Berkays/ReflowPlate/3D/README.md

## About

This project contains 3D models and design files used to create an enclosing box for the reflow plate system. It supports 4010 capacitor cooling fan, 128x64 0.96" OLED display, Rotary encoder module.

Public Onshape project can be accessed at [https://cad.onshape.com/documents/fabf8b8485aba982e8e00938/w/3c16bb25b752a8fd39e094e7/e/187e14039f52f81eb8a33bf7](https://cad.onshape.com/documents/fabf8b8485aba982e8e00938/w/3c16bb25b752a8fd39e094e7/e/187e14039f52f81eb8a33bf7)

## License

<br />This work is licensed under a <a rel="license" href="http://creativecommons.org/licenses/by/3.0/">Creative Commons Attribution 3.0 Unported License</a>.
