Berkays/ReflowPlate/GUI/README.md

## About

This project contains PC application for monitoring and profile load/save purposes. Application is developed with Electron to be cross compatible with all major platforms. App is developed with Jlink RTT communication. Standard STLink can be converted to a JLink Device with the official [SEGGER STLinkReflash utility](https://www.segger.com/products/debug-probes/j-link/models/other-j-links/st-link-on-board/) tool.

## Attribution

Dependecies below are used to realize this project. Be aware that these dependecies may have different licenses and may not be suitable for your use case.

- [ElectronJS](https://github.com/electron/electron)

## License

This project is licensed under the MIT License - see the [LICENSE](LICENSE) file for details.
