Berkays/ReflowPlate/Firmware/src/modules/Display/u8g2_font_unifont_t_symbols.png

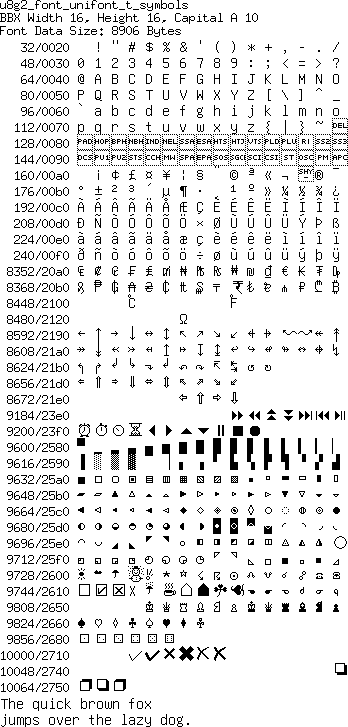
Firmware/src/modules/Display/u8g2_font_unifont_t_symbols.png
