Berkays/ReflowPlate/Hardware/V1.0_BOM.csv

ID | Name | Designator | Footprint | Quantity | Manufacturer Part | Manufacturer | Supplier | Supplier Part | Price
1 | 4.7uF | C11,C6,C8 | C0805 | 3 | CL21A475KAQNNNE | SAMSUNG(三星) | LCSC | C1779 | 0.011
2 | 2kΩ | R7 | R0805 | 1 | 0805W8F2001T5E | UNI-ROYAL(厚声) | LCSC | C17604 | 0.002
3 | 100nF | C16,C3,C4,C5,C7 | C0805 | 5 | CC0805KRX7R9BB104 | YAGEO(国巨) | LCSC | C49678 | 0.005
4 | NTC2 | H6 | HDR-F-2.54_1X2 | 1 |  |  | LCSC | C49661 | 0.035
5 | 10kΩ | R6,R14,R1,R4,R8 | R0805 | 5 | 0805W8F1002T5E | UNI-ROYAL(厚声) | LCSC | C17414 | 0.001
6 | 7A | 7A | FUSE-SMD_L6.1-W2.6 | 1 | S6125-F-5.0A | SART(萨特) | LCSC | C553942 | 0.115
7 | FAN | H5 | HDR-F-2.54_1X2 | 1 |  |  | LCSC | C49661 | 0.035
8 | AO3400A | Q4 | SOT-23-3_L2.9-W1.6-P1.90-LS2.8-BR | 1 | AO3400A | AOS | LCSC | C20917 | 0.074
9 | 150Ω | R13,R12 | R0805 | 2 | 0805W8F1500T5E | UNI-ROYAL(厚声) | LCSC | C17471 | 0.002
10 | 22uF | C1 | C0805 | 1 | CL21A226MAQNNNE | SAMSUNG(三星) | LCSC | C45783 | 0.026
11 | 10uF | C2 | C0805 | 1 | CL21A106KAYNNNE | SAMSUNG(三星) | LCSC | C15850 | 0.013
12 | 10nF | C9 | C0805 | 1 | CL21B103KBANNNC | SAMSUNG(三星) | LCSC | C1710 | 0.009
13 | 1u | C10 | CAP-D3.0×F1.5 | 1
14 | B5819W | D1,D2,D3 | SOD-123_L2.7-W1.6-LS3.7-RD-1 | 3 | B5819W SL | CJ(江苏长电/长晶) | LCSC | C8598 | 0.03
15 | SS8050 | Q1 | SOT-23-3_L2.9-W1.3-P1.90-LS2.4-BR | 1 | SS8050 | CJ(江苏长电/长晶) | LCSC | C2150 | 0.015
16 | IRLR8726TRPBF | Q2 | TO-252-2_L6.6-W6.1-P4.58-LS9.9-TL | 1 | IRLR8726TRPBF | Infineon(英飞凌) | LCSC | C81137 | 0.18
17 | WSP4409A | Q3 | SOP-8_L4.9-W3.9-P1.27-LS6.0-BL | 1 | WSP4409A | WINSOK微硕 | LCSC | C2880527 | 0.458
18 | 1kΩ | R2 | R0805 | 1 | 0805W8F1001T5E | UNI-ROYAL(厚声) | LCSC | C17513 | 0.002
19 | 4.7kΩ | R3 | R0805 | 1 | 0805W8F4701T5E | UNI-ROYAL(厚声) | LCSC | C17673 | 0.002
20 | 100kΩ | R5,R11 | R0805 | 2 | 0805W8F1003T5E | UNI-ROYAL(厚声) | LCSC | C149504 | 0.002
21 | 390kΩ | R10 | R0805 | 1 | 0805W8F3903T5E | UNI-ROYAL(厚声) | LCSC | C17656 | 0.002
22 | AMS1117-3.3 | U4 | SOT-223-3_L6.5-W3.4-P2.30-LS7.0-BR | 1 | AMS1117-3.3 | AMS | LCSC | C6186 | 0.144
23 | STM32F030C8T6 | U1 | LQFP-48_L7.0-W7.0-P0.50-LS9.0-BL | 1 | STM32F030C8T6 | ST | LCSC | C23922 | 0.912
24 | Encoder | H1 | HDR-F-2.54_1X5 | 1 |  |  | LCSC | C50950 | 0.06
25 | DISPLAY | H2 | HDR-F-2.54_1X4 | 1 |  |  | LCSC | C225501 | 0.076
26 | NTC | H3 | HDR-F-2.54_1X2 | 1 |  |  | LCSC | C49661 | 0.035
27 | SWD | H4 | HDR-F-2.54_1X4 | 1 |  |  | LCSC | C225501 | 0.076
28 | 680uF | C12,C13,C14,C15 | CAP-D10.0×F5.0 | 4
29 | 5.0-02P | U2 | CONN-TH_DG125-5.0-02P-14-00A | 1 | DG125-5.0-02P-14-00A(H) | DEGSON(高正) | LCSC | C784572 | 0.32
30 | PWR | LED1 | LED-TH_BD3.0_RED | 1 | 204-10SDRD/S530-A3-L | EVERLIGHT(台湾亿光) | LCSC | C84774 | 0.035
31 | 5.0-2P | U5 | CONN-TH_DG125-5.0-02P-14-00A | 1 | DG125-5.0-02P-14-00A(H) | DEGSON(高正) | LCSC | C784572 | 0.32
32 | SHORTING_LINK | LK3 | SHORTING_LINK_DIFF_NAMED_NETS | 1
