Berkays/ReflowPlate/Hardware/V1.0_Schematic.pdf

+

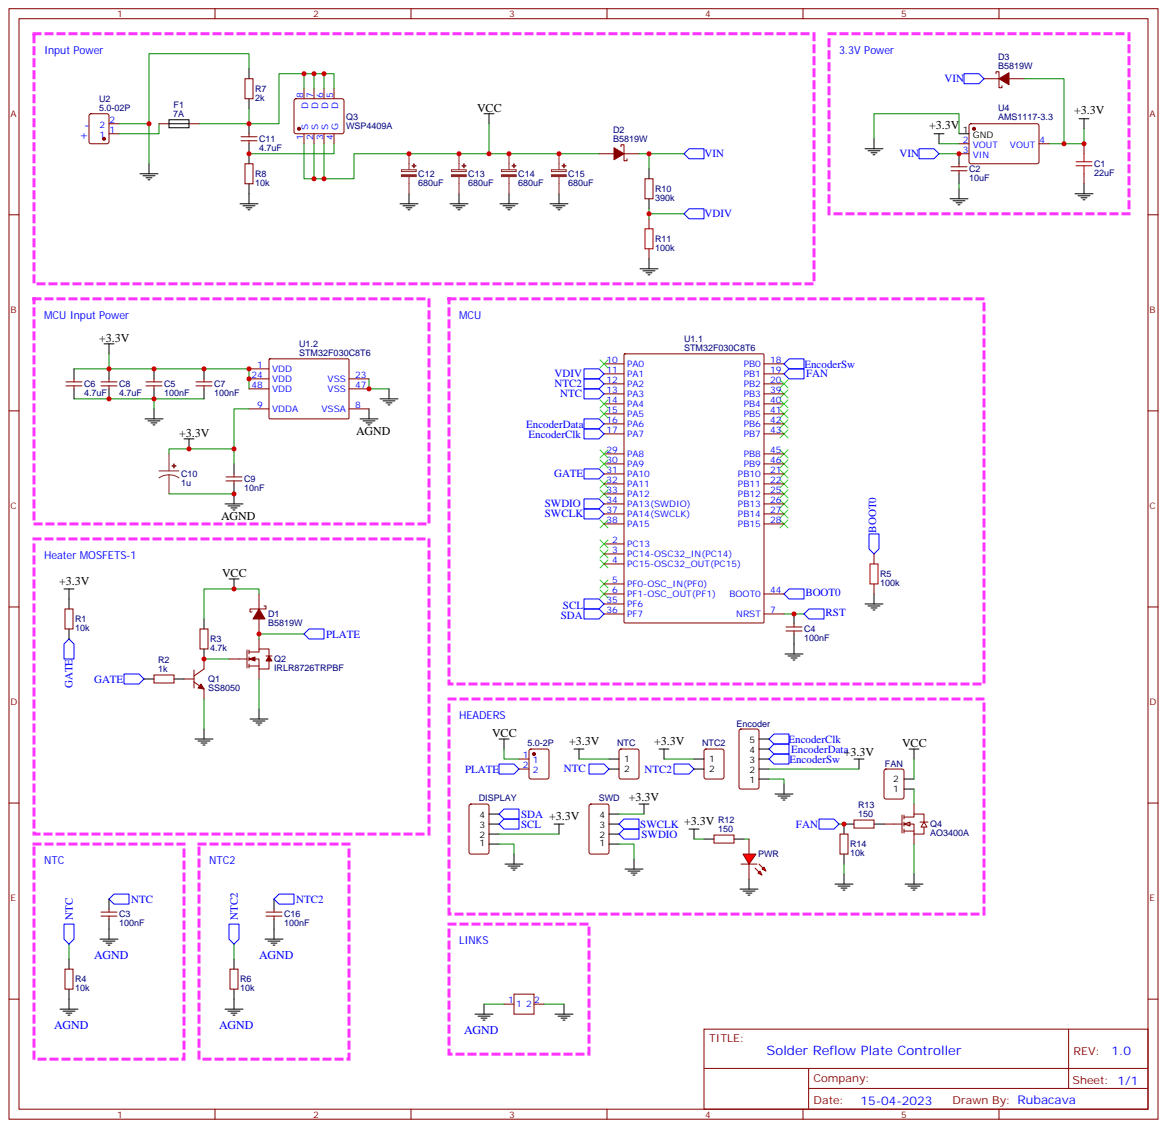
[picture p3: page 1]
