Berkays/ReflowPlate/CubeMx/V1.1_ReflowPlate.ioc

Mcu.UserName=STM32F030C8Tx
PA1.GPIO_Label=VDIV
PA1.Signal=ADC_IN1
PA10.GPIO_Label=GATE
PA10.Signal=S_TIM1_CH3
PA13.Signal=SYS_SWDIO
PA14.Signal=SYS_SWCLK
PA2.GPIO_Label=NTC2
PA2.Signal=ADC_IN2
PA3.GPIO_Label=NTC
PA3.Signal=ADC_IN3
PA6.GPIO_Label=EncoderData
PA6.Signal=S_TIM3_CH1
PA7.GPIO_Label=EncoderCLK
PA7.Signal=S_TIM3_CH2
PB0.GPIO_Label=SW
PB0.Signal=GPIO_Input
PB1.GPIO_Label=FAN
PB1.Signal=GPIO_Output
PB6.Signal=USART1_TX
PB7.Signal=USART1_RX
PC14-OSC32_IN.GPIO_Label=STATUS_LED
PC14-OSC32_IN.Signal=GPIO_Output
PF6.GPIO_Label=SCL
PF6.Signal=I2C2_SCL
PF7.GPIO_Label=SDA
PF7.Signal=I2C2_SDA
