Berkays/ReflowPlate/Firmware/src/STM32F030C8/peripherals.cpp

#include "peripherals.h"

ADC_HandleTypeDef hadc = {};
I2C_HandleTypeDef hi2c2 = {};
TIM_HandleTypeDef htim1 = {};
TIM_HandleTypeDef htim3 = {};
TIM_HandleTypeDef htim6 = {};
TIM_HandleTypeDef htim15 = {};
UART_HandleTypeDef huart1 = {};

void InitPeripherals(void)
{
    HAL_Init();

    SystemClock_Config();
    MX_GPIO_Init();
    MX_ADC_Init();
    MX_I2C2_Init();
    MX_TIM1_Init();
    MX_TIM3_Init();
    MX_TIM6_Init();
    MX_TIM15_Init();
    MX_USART1_UART_Init();
}

void SystemClock_Config(void)
{
    RCC_OscInitTypeDef RCC_OscInitStruct = {0};
    RCC_ClkInitTypeDef RCC_ClkInitStruct = {0};
    RCC_PeriphCLKInitTypeDef PeriphClkInit = {0};

    /** Initializes the RCC Oscillators according to the specified parameters
     * in the RCC_OscInitTypeDef structure.
     */
    RCC_OscInitStruct.OscillatorType = RCC_OSCILLATORTYPE_HSI | RCC_OSCILLATORTYPE_HSI14;
    RCC_OscInitStruct.HSIState = RCC_HSI_ON;
    RCC_OscInitStruct.HSI14State = RCC_HSI14_ON;
    RCC_OscInitStruct.HSICalibrationValue = RCC_HSICALIBRATION_DEFAULT;
    RCC_OscInitStruct.HSI14CalibrationValue = 16;
    RCC_OscInitStruct.PLL.PLLState = RCC_PLL_ON;
    RCC_OscInitStruct.PLL.PLLSource = RCC_PLLSOURCE_HSI;
    RCC_OscInitStruct.PLL.PLLMUL = RCC_PLL_MUL12;
    RCC_OscInitStruct.PLL.PREDIV = RCC_PREDIV_DIV1;
    if (HAL_RCC_OscConfig(&RCC_OscInitStruct) != HAL_OK)
    {
        Error_Handler();
    }

    /** Initializes the CPU, AHB and APB buses clocks
     */
    RCC_ClkInitStruct.ClockType = RCC_CLOCKTYPE_HCLK | RCC_CLOCKTYPE_SYSCLK | RCC_CLOCKTYPE_PCLK1;
    RCC_ClkInitStruct.SYSCLKSource = RCC_SYSCLKSOURCE_PLLCLK;
    RCC_ClkInitStruct.AHBCLKDivider = RCC_SYSCLK_DIV1;
    RCC_ClkInitStruct.APB1CLKDivider = RCC_HCLK_DIV1;

    if (HAL_RCC_ClockConfig(&RCC_ClkInitStruct, FLASH_LATENCY_1) != HAL_OK)
    {
        Error_Handler();
    }
    PeriphClkInit.PeriphClockSelection = RCC_PERIPHCLK_USART1;
    PeriphClkInit.Usart1ClockSelection = RCC_USART1CLKSOURCE_PCLK1;
    if (HAL_RCCEx_PeriphCLKConfig(&PeriphClkInit) != HAL_OK)
    {
        Error_Handler();
    }
}

/**
 * @brief ADC Initialization Function
 * @param None
 * @retval None
 */
void MX_ADC_Init(void)
{

    ADC_ChannelConfTypeDef sConfig = {0};

    /** Configure the global features of the ADC (Clock, Resolution, Data Alignment and number of conversion)
     */
    hadc.Instance = ADC1;
    hadc.Init.ClockPrescaler = ADC_CLOCK_ASYNC_DIV1;
    hadc.Init.Resolution = ADC_RESOLUTION_12B;
    hadc.Init.DataAlign = ADC_DATAALIGN_RIGHT;
    hadc.Init.ScanConvMode = ADC_SCAN_DIRECTION_FORWARD;
    hadc.Init.EOCSelection = ADC_EOC_SEQ_CONV;
    hadc.Init.LowPowerAutoWait = DISABLE;
    hadc.Init.LowPowerAutoPowerOff = DISABLE;
    hadc.Init.ContinuousConvMode = DISABLE;
    hadc.Init.DiscontinuousConvMode = DISABLE;
    hadc.Init.ExternalTrigConv = ADC_SOFTWARE_START;
    hadc.Init.ExternalTrigConvEdge = ADC_EXTERNALTRIGCONVEDGE_NONE;
    hadc.Init.DMAContinuousRequests = DISABLE;
    hadc.Init.Overrun = ADC_OVR_DATA_OVERWRITTEN;
    if (HAL_ADC_Init(&hadc) != HAL_OK)
    {
        Error_Handler();
    }

    /** Configure for the selected ADC regular channel to be converted.
     */
    sConfig.Channel = ADC_CHANNEL_1;
    sConfig.Rank = ADC_RANK_CHANNEL_NUMBER;
    sConfig.SamplingTime = ADC_SAMPLETIME_13CYCLES_5;
    if (HAL_ADC_ConfigChannel(&hadc, &sConfig) != HAL_OK)
    {
        Error_Handler();
    }

    /** Configure for the selected ADC regular channel to be converted.
     */
    sConfig.Channel = ADC_CHANNEL_2;
    if (HAL_ADC_ConfigChannel(&hadc, &sConfig) != HAL_OK)
    {
        Error_Handler();
    }

    /** Configure for the selected ADC regular channel to be converted.
     */
    sConfig.Channel = ADC_CHANNEL_3;
    if (HAL_ADC_ConfigChannel(&hadc, &sConfig) != HAL_OK)
    {
        Error_Handler();
    }
}

/**
 * @brief I2C2 Initialization Function
 * @param None
 * @retval None
 */
void MX_I2C2_Init(void)
{

    hi2c2.Instance = I2C2;
    hi2c2.Init.Timing = 0x00401A58;
    hi2c2.Init.OwnAddress1 = 120;
    hi2c2.Init.AddressingMode = I2C_ADDRESSINGMODE_7BIT;
    hi2c2.Init.DualAddressMode = I2C_DUALADDRESS_DISABLE;
    hi2c2.Init.OwnAddress2 = 0;
    hi2c2.Init.OwnAddress2Masks = I2C_OA2_NOMASK;
    hi2c2.Init.GeneralCallMode = I2C_GENERALCALL_DISABLE;
    hi2c2.Init.NoStretchMode = I2C_NOSTRETCH_DISABLE;
    if (HAL_I2C_Init(&hi2c2) != HAL_OK)
    {
        Error_Handler();
    }

    /** Configure Analogue filter
     */
    if (HAL_I2CEx_ConfigAnalogFilter(&hi2c2, I2C_ANALOGFILTER_DISABLE) != HAL_OK)
    {
        Error_Handler();
    }

    /** Configure Digital filter
     */
    if (HAL_I2CEx_ConfigDigitalFilter(&hi2c2, 0) != HAL_OK)
    {
        Error_Handler();
    }
}

/**
 * @brief TIM1 Initialization Function
 * @param None
 * @retval None
 */
void MX_TIM1_Init(void)
{

    TIM_ClockConfigTypeDef sClockSourceConfig = {0};
    TIM_MasterConfigTypeDef sMasterConfig = {0};
    TIM_OC_InitTypeDef sConfigOC = {0};
    TIM_BreakDeadTimeConfigTypeDef sBreakDeadTimeConfig = {0};

    htim1.Instance = TIM1;
    htim1.Init.Prescaler = 42;
    htim1.Init.CounterMode = TIM_COUNTERMODE_UP;
    htim1.Init.Period = 999;
    htim1.Init.ClockDivision = TIM_CLOCKDIVISION_DIV1;
    htim1.Init.RepetitionCounter = 0;
    htim1.Init.AutoReloadPreload = TIM_AUTORELOAD_PRELOAD_DISABLE;
    if (HAL_TIM_Base_Init(&htim1) != HAL_OK)
    {
        Error_Handler();
    }
    sClockSourceConfig.ClockSource = TIM_CLOCKSOURCE_INTERNAL;
    if (HAL_TIM_ConfigClockSource(&htim1, &sClockSourceConfig) != HAL_OK)
    {
        Error_Handler();
    }
    if (HAL_TIM_PWM_Init(&htim1) != HAL_OK)
    {
        Error_Handler();
    }
    sMasterConfig.MasterOutputTrigger = TIM_TRGO_RESET;
    sMasterConfig.MasterSlaveMode = TIM_MASTERSLAVEMODE_DISABLE;
    if (HAL_TIMEx_MasterConfigSynchronization(&htim1, &sMasterConfig) != HAL_OK)
    {
        Error_Handler();
    }
    sConfigOC.OCMode = TIM_OCMODE_PWM1;
    sConfigOC.Pulse = 0;
    sConfigOC.OCPolarity = TIM_OCPOLARITY_LOW;
    sConfigOC.OCNPolarity = TIM_OCNPOLARITY_HIGH;
    sConfigOC.OCFastMode = TIM_OCFAST_ENABLE;
    sConfigOC.OCIdleState = TIM_OCIDLESTATE_SET;
    sConfigOC.OCNIdleState = TIM_OCNIDLESTATE_RESET;
    if (HAL_TIM_PWM_ConfigChannel(&htim1, &sConfigOC, TIM_CHANNEL_3) != HAL_OK)
    {
        Error_Handler();
    }
    sBreakDeadTimeConfig.OffStateRunMode = TIM_OSSR_DISABLE;
    sBreakDeadTimeConfig.OffStateIDLEMode = TIM_OSSI_DISABLE;
    sBreakDeadTimeConfig.LockLevel = TIM_LOCKLEVEL_OFF;
    sBreakDeadTimeConfig.DeadTime = 0;
    sBreakDeadTimeConfig.BreakState = TIM_BREAK_DISABLE;
    sBreakDeadTimeConfig.BreakPolarity = TIM_BREAKPOLARITY_HIGH;
    sBreakDeadTimeConfig.AutomaticOutput = TIM_AUTOMATICOUTPUT_DISABLE;
    if (HAL_TIMEx_ConfigBreakDeadTime(&htim1, &sBreakDeadTimeConfig) != HAL_OK)
    {
        Error_Handler();
    }
    HAL_TIM_MspPostInit(&htim1);
}

/**
 * @brief TIM3 Initialization Function
 * @param None
 * @retval None
 */
void MX_TIM3_Init(void)
{

    TIM_Encoder_InitTypeDef sConfig = {0};
    TIM_MasterConfigTypeDef sMasterConfig = {0};

    htim3.Instance = TIM3;
    htim3.Init.Prescaler = 0;
    htim3.Init.CounterMode = TIM_COUNTERMODE_UP;
    htim3.Init.Period = 65535;
    htim3.Init.ClockDivision = TIM_CLOCKDIVISION_DIV1;
    htim3.Init.AutoReloadPreload = TIM_AUTORELOAD_PRELOAD_ENABLE;
    sConfig.EncoderMode = TIM_ENCODERMODE_TI12;
    sConfig.IC1Polarity = TIM_ICPOLARITY_RISING;
    sConfig.IC1Selection = TIM_ICSELECTION_DIRECTTI;
    sConfig.IC1Prescaler = TIM_ICPSC_DIV1;
    sConfig.IC1Filter = 10;
    sConfig.IC2Polarity = TIM_ICPOLARITY_RISING;
    sConfig.IC2Selection = TIM_ICSELECTION_DIRECTTI;
    sConfig.IC2Prescaler = TIM_ICPSC_DIV1;
    sConfig.IC2Filter = 10;
    if (HAL_TIM_Encoder_Init(&htim3, &sConfig) != HAL_OK)
    {
        Error_Handler();
    }
    sMasterConfig.MasterOutputTrigger = TIM_TRGO_RESET;
    sMasterConfig.MasterSlaveMode = TIM_MASTERSLAVEMODE_DISABLE;
    if (HAL_TIMEx_MasterConfigSynchronization(&htim3, &sMasterConfig) != HAL_OK)
    {
        Error_Handler();
    }
}

/**
 * @brief TIM6 Initialization Function
 * @param None
 * @retval None
 */
void MX_TIM6_Init(void)
{

    htim6.Instance = TIM6;
    htim6.Init.Prescaler = 47999;
    htim6.Init.CounterMode = TIM_COUNTERMODE_UP;
    htim6.Init.Period = 999;
    htim6.Init.AutoReloadPreload = TIM_AUTORELOAD_PRELOAD_ENABLE;
    if (HAL_TIM_Base_Init(&htim6) != HAL_OK)
    {
        Error_Handler();
    }
}

/**
 * @brief TIM15 Initialization Function
 * @param None
 * @retval None
 */
void MX_TIM15_Init(void)
{

    TIM_ClockConfigTypeDef sClockSourceConfig = {0};
    TIM_MasterConfigTypeDef sMasterConfig = {0};

    htim15.Instance = TIM15;
    htim15.Init.Prescaler = 47;
    htim15.Init.CounterMode = TIM_COUNTERMODE_UP;
    htim15.Init.Period = 65535;
    htim15.Init.ClockDivision = TIM_CLOCKDIVISION_DIV1;
    htim15.Init.RepetitionCounter = 0;
    htim15.Init.AutoReloadPreload = TIM_AUTORELOAD_PRELOAD_DISABLE;
    if (HAL_TIM_Base_Init(&htim15) != HAL_OK)
    {
        Error_Handler();
    }
    sClockSourceConfig.ClockSource = TIM_CLOCKSOURCE_INTERNAL;
    if (HAL_TIM_ConfigClockSource(&htim15, &sClockSourceConfig) != HAL_OK)
    {
        Error_Handler();
    }
    sMasterConfig.MasterOutputTrigger = TIM_TRGO_RESET;
    sMasterConfig.MasterSlaveMode = TIM_MASTERSLAVEMODE_DISABLE;
    if (HAL_TIMEx_MasterConfigSynchronization(&htim15, &sMasterConfig) != HAL_OK)
    {
        Error_Handler();
    }
}

/**
 * @brief USART1 Initialization Function
 * @param None
 * @retval None
 */
void MX_USART1_UART_Init(void)
{

    huart1.Instance = USART1;
    huart1.Init.BaudRate = 9600;
    huart1.Init.WordLength = UART_WORDLENGTH_8B;
    huart1.Init.StopBits = UART_STOPBITS_1;
    huart1.Init.Parity = UART_PARITY_NONE;
    huart1.Init.Mode = UART_MODE_TX_RX;
    huart1.Init.HwFlowCtl = UART_HWCONTROL_NONE;
    huart1.Init.OverSampling = UART_OVERSAMPLING_16;
    huart1.Init.OneBitSampling = UART_ONE_BIT_SAMPLE_DISABLE;
    huart1.AdvancedInit.AdvFeatureInit = UART_ADVFEATURE_NO_INIT;
    if (HAL_UART_Init(&huart1) != HAL_OK)
    {
        Error_Handler();
    }
}

/**
 * @brief GPIO Initialization Function
 * @param None
 * @retval None
 */
void MX_GPIO_Init(void)
{
    GPIO_InitTypeDef GPIO_InitStruct = {0};
    /* GPIO Ports Clock Enable */
    __HAL_RCC_GPIOC_CLK_ENABLE();
    __HAL_RCC_GPIOA_CLK_ENABLE();
    __HAL_RCC_GPIOB_CLK_ENABLE();
    __HAL_RCC_GPIOF_CLK_ENABLE();

    /*Configure GPIO pin Output Level */
    HAL_GPIO_WritePin(STATUS_LED_GPIO_Port, STATUS_LED_Pin, GPIO_PIN_RESET);

    /*Configure GPIO pin Output Level */
    HAL_GPIO_WritePin(FAN_GPIO_Port, FAN_Pin, GPIO_PIN_RESET);

    /*Configure GPIO pin : STATUS_LED_Pin */
    GPIO_InitStruct.Pin = STATUS_LED_Pin;
    GPIO_InitStruct.Mode = GPIO_MODE_OUTPUT_PP;
    GPIO_InitStruct.Pull = GPIO_NOPULL;
    GPIO_InitStruct.Speed = GPIO_SPEED_FREQ_LOW;
    HAL_GPIO_Init(STATUS_LED_GPIO_Port, &GPIO_InitStruct);

    /*Configure GPIO pin : SW_Pin */
    GPIO_InitStruct.Pin = SW_Pin;
    GPIO_InitStruct.Mode = GPIO_MODE_INPUT;
    GPIO_InitStruct.Pull = GPIO_PULLUP;
    HAL_GPIO_Init(SW_GPIO_Port, &GPIO_InitStruct);

    /*Configure GPIO pin : FAN_Pin */
    GPIO_InitStruct.Pin = FAN_Pin;
    GPIO_InitStruct.Mode = GPIO_MODE_OUTPUT_PP;
    GPIO_InitStruct.Pull = GPIO_NOPULL;
    GPIO_InitStruct.Speed = GPIO_SPEED_FREQ_LOW;
    HAL_GPIO_Init(FAN_GPIO_Port, &GPIO_InitStruct);

}

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
