Berkays/ReflowPlate/Firmware/include/Base.h

#include "Macros.h"

#define ENABLED == 1
#define DISABLED == 0
#define USING(feature) 1 feature

#define HIGH GPIO_PIN_SET
#define LOW GPIO_PIN_RESET

#define SERIAL_TYPE_UART 1
#define SERIAL_TYPE_RTT 2
