Berkays/ReflowPlate/(commit log)

2023-12-20 Add input voltage as a config value
2023-12-20 Add UART support
2023-12-20 Add status led with pinUtils
2023-12-20 Update CubeMx drivers
